StaRadian/sutterspeed/kicad/production/bom.csv

Designator | Footprint | Quantity | Value | LCSC Part #
C1 | 0603 | 1 | 10uF | C19702
C10, C4, C6, C9 | 0402 | 4 | 100nF | C1525
C11, C12, C14 | 0402 | 3 | 1nF | C1523
C13, C8 | 0402 | 2 | 10pF | C32949
C2, C3, C5 | 0402 | 3 | 1uF | C52923
C7 | 0402 | 1 | 47pF | C1567
D1 | Vishay_TEMD5510FX01 | 1 | TEMD5510FX01 | C94856
FB1 | 0603 | 1 | BLM18PG221SN1D | C80165
R1, R2 | 0402 | 2 | 5.1k | C25905
R10, R11, R14 | 0402 | 3 | 100 | C25076
R12, R3, R5, R6, R9 | 0402 | 5 | 10k | C25744
R13, R7 | 0402 | 2 | 1k | C11702
R8 | 0402 | 1 | 100k | C25741
U1 | QFN-28_4x4mm_P0.5mm | 1 | STM32C071G8U6 | C44521811
U2 | SOT-23-5 | 1 | ME6211C33M5G-N | C82942
U3 | SOT-23-6 | 1 | USBLC6-2SC6 | C7519
U4 | TSSOP-14_4.4x5mm_P0.65mm | 1 | TLV9064IPWR | C779410
