StaRadian/sutterspeed/kicad/sutterspeed.kicad_pcb

## KiCad design kicad/sutterspeed.kicad_pcb (2026-10-21)

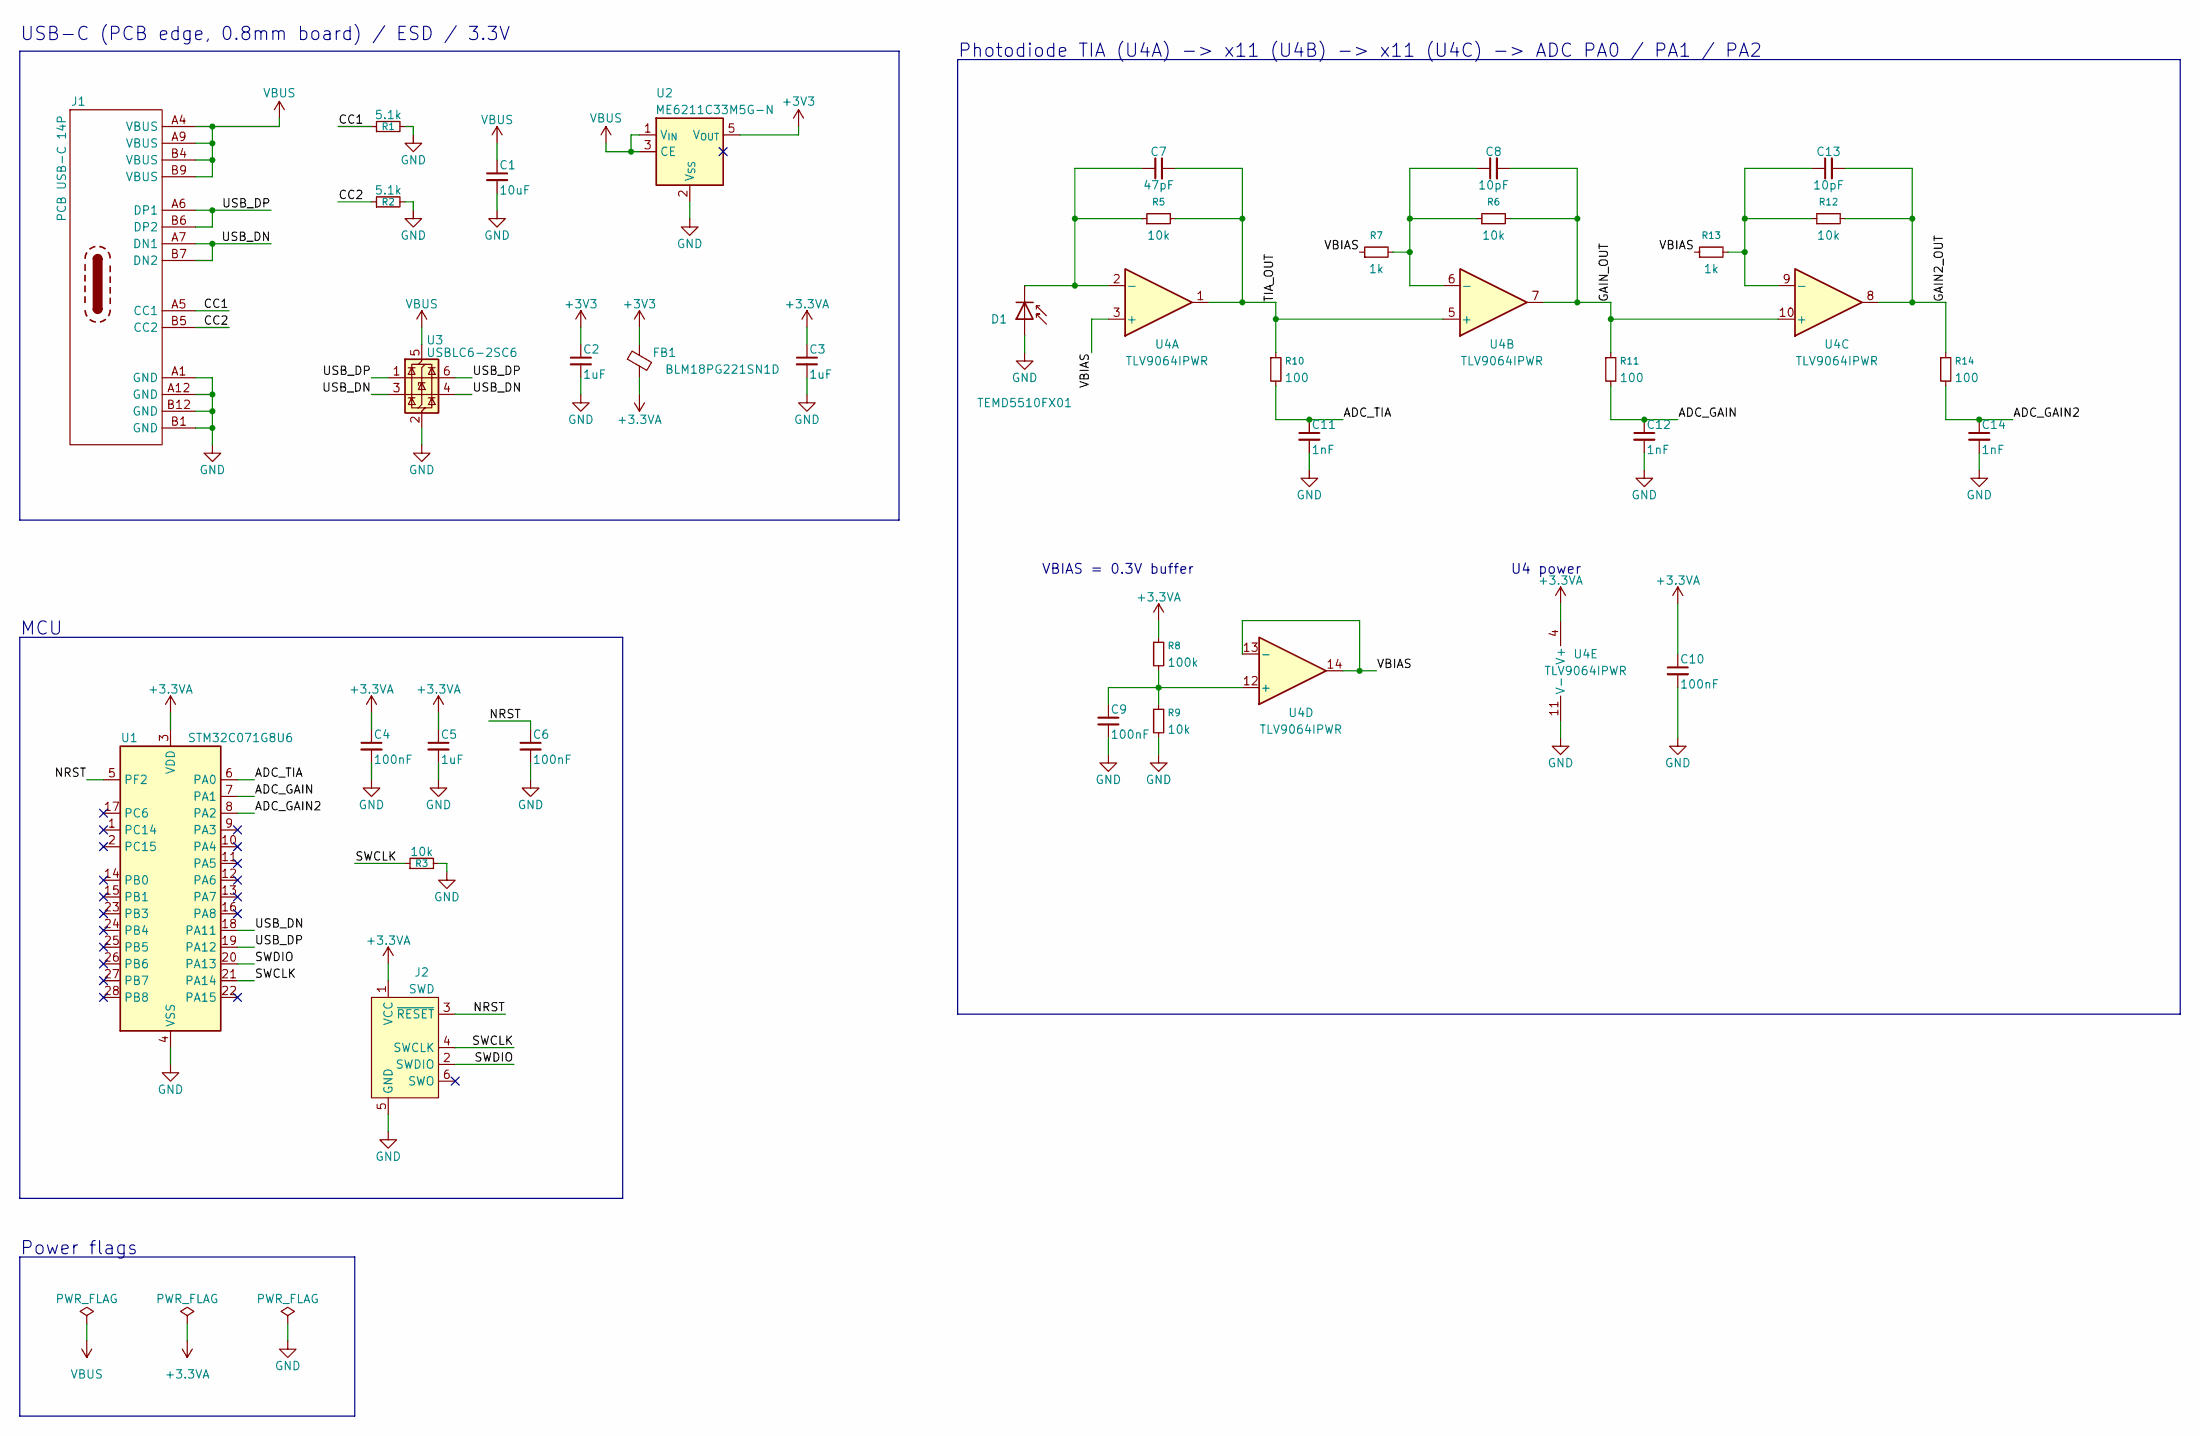
[picture p2: schematic sutterspeed.kicad_sch, Sutterspeed - shutter speed tester]

Parts:
C1: 10uF; C_0603_1608Metric; LCSC C19702
C2, C3, C5: 1uF; C_0402_1005Metric; LCSC C52923
C4, C6, C9, C10: 100nF; C_0402_1005Metric; LCSC C1525
C7: 47pF; C_0402_1005Metric; LCSC C1567
C8, C13: 10pF; C_0402_1005Metric; LCSC C32949
C11, C12, C14: 1nF; C_0402_1005Metric; LCSC C1523
D1: TEMD5510FX01; Vishay_TEMD5510FX01; MPN TEMD5510FX01; LCSC C94856
FB1: BLM18PG221SN1D; L_0603_1608Metric; LCSC C80165
J1: PCB USB-C 14P; PCBTypeC_14P
J2: SWD; Tag-Connect_TC2030-IDC-NL_2x03_P1.27mm_Vertical
R1, R2: 5.1k; R_0402_1005Metric; LCSC C25905
R3, R5, R6, R9, R12: 10k; R_0402_1005Metric; LCSC C25744
R7, R13: 1k; R_0402_1005Metric; LCSC C11702
R8: 100k; R_0402_1005Metric; LCSC C25741
R10, R11, R14: 100; R_0402_1005Metric; LCSC C25076
U1: STM32C071G8U6; QFN-28_4x4mm_P0.5mm; LCSC C44521811
U2: ME6211C33M5G-N; SOT-23-5; LCSC C82942
U3: USBLC6-2SC6; SOT-23-6; LCSC C7519
U4: TLV9064IPWR; TSSOP-14_4.4x5mm_P0.65mm; LCSC C779410

Connections:
+3.3VA: C3.1, C4.1, C5.1, C10.1, FB1.2, J2.1 (VCC), R8.1, U1.3 (VDD), U4.4 (V+)
+3V3: C2.1, FB1.1, U2.5 (V_{OUT})
/ADC_GAIN: C12.1, R11.2, U1.7 (PA1)
/ADC_GAIN2: C14.1, R14.2, U1.8 (PA2)
/ADC_TIA: C11.1, R10.2, U1.6 (PA0)
/CC1: J1.A5 (CC1), R1.1
/CC2: J1.B5 (CC2), R2.1
/GAIN2_OUT: C13.2, R12.2, R14.1, U4.8
/GAIN_OUT: C8.2, R6.2, R11.1, U4.7, U4.10 (+)
/NRST: C6.1, J2.3 (~RESET), U1.5 (PF2)
/SWCLK: J2.4 (SWCLK), R3.1, U1.21 (PA14)
/SWDIO: J2.2 (SWDIO), U1.20 (PA13)
/TIA_OUT: C7.2, R5.2, R10.1, U4.1, U4.5 (+)
/USB_DN: J1.A7 (DN1), J1.B7 (DN2), U1.18 (PA11), U3.3 (I/O2), U3.4 (I/O2)
/USB_DP: J1.A6 (DP1), J1.B6 (DP2), U1.19 (PA12), U3.1 (I/O1), U3.6 (I/O1)
/VBIAS: R7.1, R13.1, U4.3 (+), U4.13 (-), U4.14
GND: C1.2, C2.2, C3.2, C4.2, C5.2, C6.2, C9.2, C10.2, C11.2, C12.2, C14.2, D1.2 (A), J1.A1 (GND), J1.A12 (GND), J1.B1 (GND), J1.B12 (GND), J2.5 (GND), R1.2, R2.2, R3.2, R9.2, U1.4 (VSS), U2.2 (V_{SS}), U3.2 (GND), U4.11 (V-)
unnamed: C7.1, D1.1 (K), R5.1, U4.2 (-)
unnamed: C8.1, R6.1, R7.2, U4.6 (-)
unnamed: C13.1, R12.1, R13.2, U4.9 (-)
unnamed: C9.1, R8.2, R9.1, U4.12 (+)
VBUS: C1.1, J1.A4 (VBUS), J1.A9 (VBUS), J1.B4 (VBUS), J1.B9 (VBUS), U2.1 (V_{IN}), U2.3 (CE), U3.5 (VBUS)

Notes on the sheet:
Photodiode TIA (U4A) -> x11 (U4B) -> x11 (U4C) -> ADC PA0 / PA1 / PA2
USB-C (PCB edge, 0.8mm board) / ESD / 3.3V
Power flags
MCU
VBIAS = 0.3V buffer
U4 power

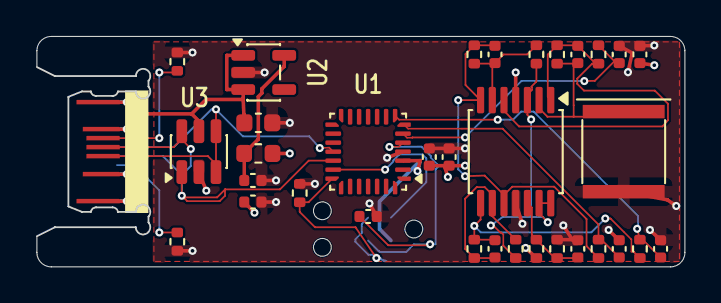
[picture p3: board sutterspeed.kicad_pcb from above]

Board: 4 copper layers, 36.0 x 12.8 mm, 35 parts (1 on the bottom side), 22 nets.
