StaRadian/sutterspeed/code/sutterspeed.ioc

Mcu.UserName=STM32C071G8Ux
PA0.Signal=ADC1_IN0
PA13.Signal=DEBUG_SWDIO
PA14-BOOT0.Signal=DEBUG_SWCLK
PC14-OSCX_IN(PC14).Signal=RCC_OSCX_IN
