StaRadian/sutterspeed/firmware/src/tusb_config.h

#ifndef TUSB_CONFIG_H
#define TUSB_CONFIG_H

#define CFG_TUSB_OS             OPT_OS_NONE
#define CFG_TUD_ENABLED         1
#define CFG_TUD_MAX_SPEED       OPT_MODE_FULL_SPEED
#define CFG_TUD_ENDPOINT0_SIZE  64

#define CFG_TUD_CDC             1
#define CFG_TUD_MSC             0
#define CFG_TUD_HID             0
#define CFG_TUD_MIDI            0
#define CFG_TUD_VENDOR          0

#define CFG_TUD_CDC_RX_BUFSIZE  128
#define CFG_TUD_CDC_TX_BUFSIZE  1024
#define CFG_TUD_CDC_EP_BUFSIZE  64

#endif
