StaRadian/sutterspeed/(commit log)

2026-10-21 Light oscilloscope firmware, Windows viewer and repository clean-up
    - firmware 0.3.2: 400 kS/s scope engine (decimation, trigger, roll, shutter pulse capture), USB CDC protocol, DFU entry
    - viewer (Rust/egui): scope controls, filters, measurements, cursors, shutter measurement, USB firmware update
    - host test of the scope engine
    - libraries as submodules; KiCad backups and local state ignored; READMEs
2026-10-22 Firmware 0.3.7 and viewer: simpler shutter measurement, min-width trigger, gain diagnostics
    - shutter measurement: open time = rising to falling crossing of the trigger level (filtered when a filter is set);
    trigger on a 40 us average (or the filter), works like SINGLE, scope screen kept dimmed until the pulse
    - trigger minimum width (MIN WIDTH knob): crossings that go back sooner are passed over, scope and shutter mode
    - trigger only up to 10 ms/div (slower time bases roll); NORMAL/SINGLE need the trigger on; SINGLE dims the old trace
    - level / edge changes applied in place without restarting the capture; roll screen kept on trigger changes
    - stage gains learned on block means; `adc` comm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
2026-10-31 Update from GitHub: newest release's firmware and viewer from the update window
    - "Update from GitHub" in the update window: finds the newest release, writes its firmware when the board's is
    older (the board reports its version on connect) and replaces the running viewer when it is older
    (old exe moved aside, removed on the next start); "Restart viewer" afterwards
    - `--update` on the command line replaces the viewer only
    - versions follow the release tags: firmware and viewer 0.3.8
2026-11-01 USB bootloader: firmware updates without a driver install
    - boot/: 12 KB DFU 1.1 bootloader (1209:0002) with Microsoft OS 2.0 descriptors, so Windows binds
    WinUSB by itself; writes the firmware's first double word last, so an interrupted update stays in
    the bootloader. Firmware moves to 0x08003000; sutterspeed.hex is the whole image.
    - Firmware 0.4.0: `dfu` restarts into the bootloader, `dfu rom` into the ST one; a hard fault
    restarts into the bootloader.
    - Viewer 0.4.0: writes through our bootloader or, for older boards and blank chips, the whole
    image through the ST bootloader; binds Windows' WinUSB to the ST bootloader when it has no driver
    (elevated --install-driver).
    Co-Autho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
2026-11-01 Viewer and firmware 0.4.1: firmware built into the viewer
    "Write built-in firmware" in the update window (and `--flash` without a file) writes the
    release's sutterspeed.hex that is compiled into the viewer: no internet needed, blank boards too.
2026-11-01 Viewer: trigger back on after the time base leaves the roll range
    Turning the time base into the roll range switches the trigger off; turning back now switches it
    on again in the mode it had. Switched off by hand it stays off.
